Domochip/WirelessTouchLight/box/WirelessTouchLight Lid.stl

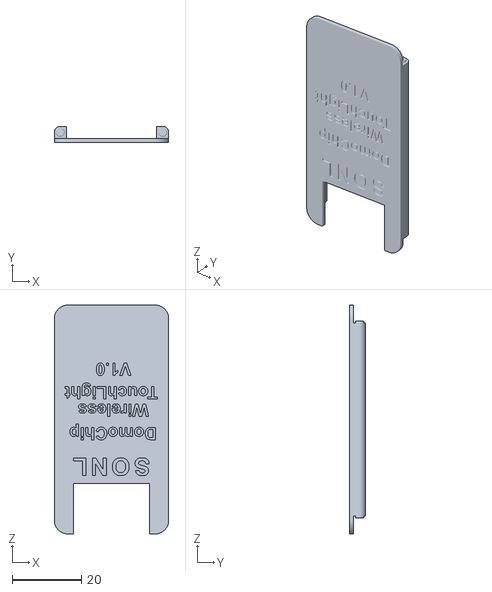
[picture p1: CAD file, 2019-11-03]
box/WirelessTouchLight Lid.stl
33.0 x 4.75 x 66.0
