Domochip/WirelessTouchLight/box/WirelessTouchLight Box.stl

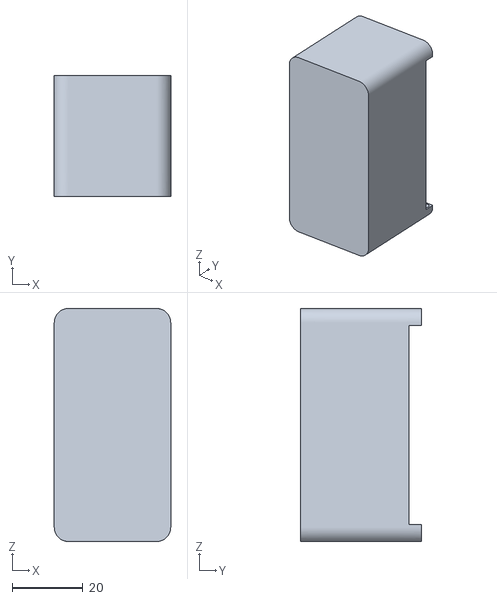
[picture p2: CAD file, 2019-11-03]
box/WirelessTouchLight Box.stl
33.0 x 34.2 x 66.0
