Domochip/WirelessTouchLight/(list of files, cad)

Other CAD files:
box/WirelessTouchLight v5.f3d
