Domochip/WirelessTouchLight/schematic/WirelessTouchLight.kicad_pcb

## KiCad design schematic/WirelessTouchLight.kicad_pcb (2020-03-07)

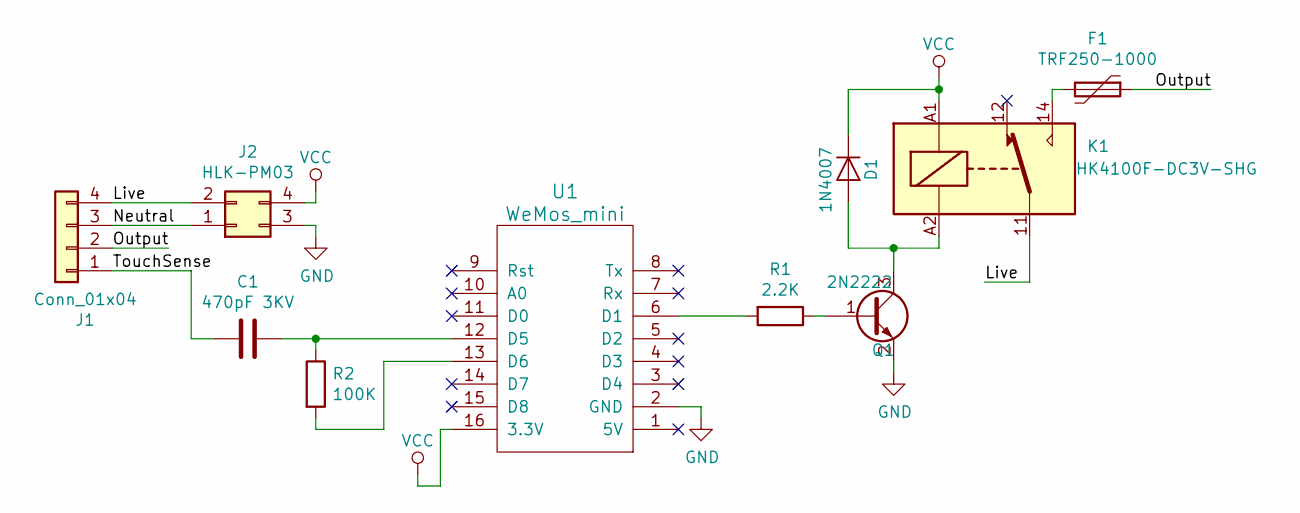
[picture p3: schematic WirelessTouchLight.sch]

Parts:
C1: 470pF 3KV; CP_Radial_Tantal_D4.5mm_P5.00mm
D1: 1N4007; D_SMA_Handsoldering
F1: TRF250-1000
J1: Conn_01x04; KF235-4P
J2: HLK-PM03; HLK-PM01
K1: HK4100F-DC3V-SHG; HK4100F
Q1: 2N2222; SOT-23_Handsoldering
R1: 2.2K; R_0805_HandSoldering
R2: 100K; R_0805_HandSoldering
U1: WeMos_mini; wemos-d1-mini-DIL-only

Connections:
/Live: J1.4, J2.2, K1.11
/Neutral: J1.3, J2.1
/Output: F1.1, J1.2
/TouchSense: C1.2, J1.1
GND: J2.3, Q1.2 (E), U1.2 (GND)
unnamed: C1.1, R2.1, U1.12 (D5)
unnamed: D1.2 (A), K1.A2, Q1.3 (C)
unnamed: F1.2, K1.14
unnamed: Q1.1 (B), R1.1
unnamed: R1.2, U1.6 (D1)
unnamed: R2.2, U1.13 (D6)
VCC: D1.1 (K), J2.4, K1.A1, U1.16 (3.3V)

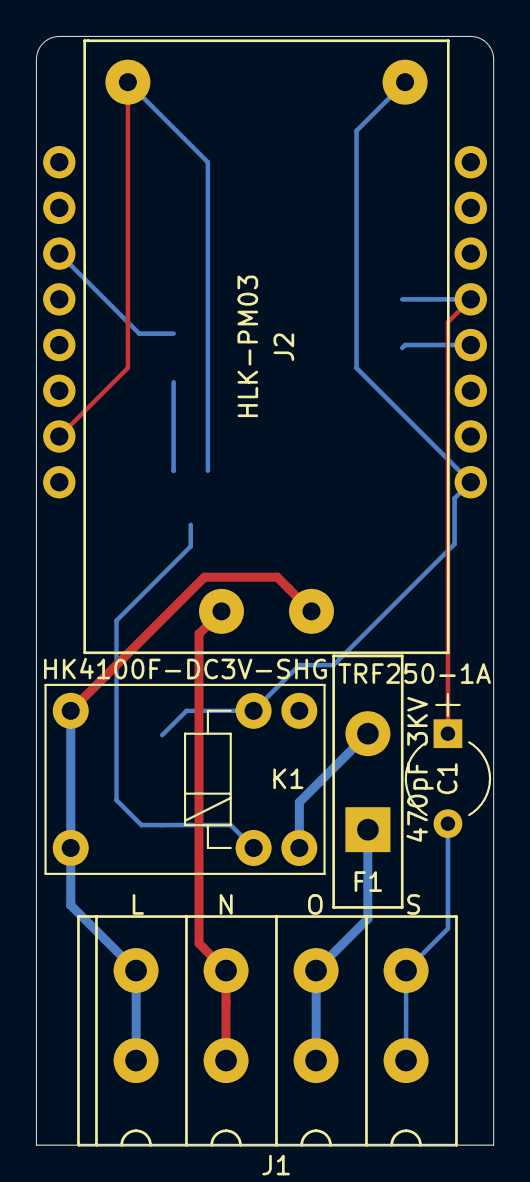
[picture p4: board WirelessTouchLight.kicad_pcb from above]

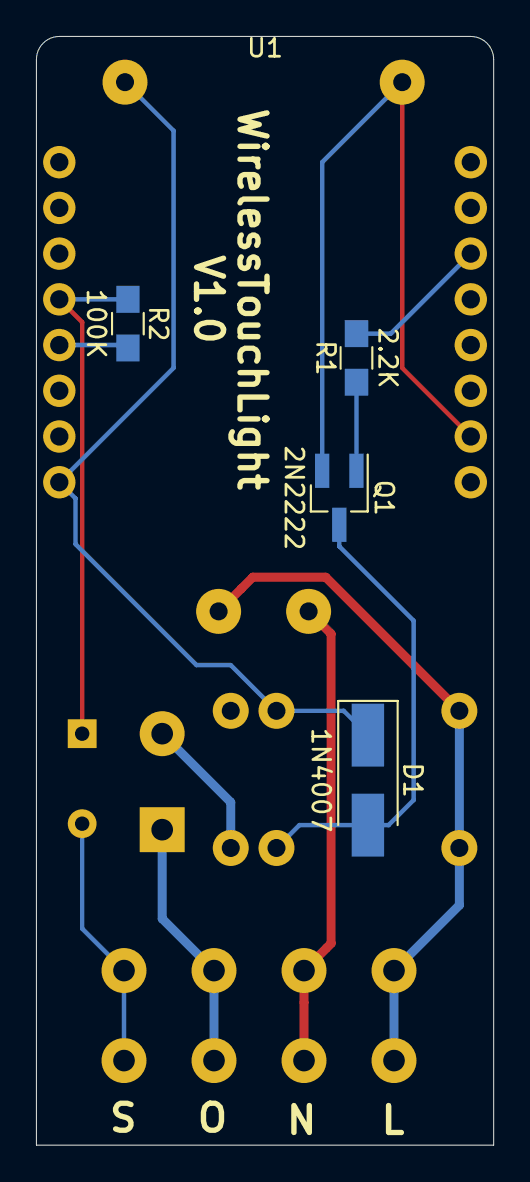
[picture p5: board WirelessTouchLight.kicad_pcb from below]

Board: 2 copper layers, 25.4 x 61.6 mm, 10 parts (5 on the bottom side), 12 nets.
