Domochip/WirelessTouchLight/(commit log)

2019-09-29 Add schematic
    [WirelessTouchLite.kicad_pcb, WirelessTouchLite.sch]
2019-10-02 change to D1 Mini Shelly 1 is noisy!
    [WirelessTouchLight.kicad_pcb, WirelessTouchLight.sch, WirelessTouchLite.sch]
2019-10-10 Update schematic
    [WirelessTouchLight-B_Cu.gbl, WirelessTouchLight-B_Mask.gbs, WirelessTouchLight-B_Paste.gbp, WirelessTouchLight-B_SilkS.gbo, WirelessTouchLight-Edge_Cuts.gm1, WirelessTouchLight-F_Cu.gtl, WirelessTouchLight-F_Mask.gts, WirelessTouchLight-F_Paste.gtp]
2019-11-03 V0.9 Switch to D1 Mini
2019-11-03 Add Box
    [WirelessTouchLight Box.stl, WirelessTouchLight Lid.stl, WirelessTouchLight v5.f3d]
2019-11-24 Change to 470K Resistor
    [WirelessTouchLight-B_Cu.gbl, WirelessTouchLight-B_Mask.gbs, WirelessTouchLight-B_Paste.gbp, WirelessTouchLight-B_SilkS.gbo, WirelessTouchLight-Edge_Cuts.gm1, WirelessTouchLight-F_Cu.gtl, WirelessTouchLight-F_Mask.gts, WirelessTouchLight-F_Paste.gtp]
2019-11-24 V1.1.1 add last Capactive sensor Value to status
2019-12-03 Remove CapacitiveSensor
2019-12-05 Change Back to 100K resistor (470 too much noises)
    [WirelessTouchLight.kicad_pcb, WirelessTouchLight.sch]
2019-12-05 V1.2.0 switch back to CapacitiveSensor
2019-12-05 Improve Web for calibration
2019-12-05 V1.2.3 use threshold level instead of sampleNumber
2020-03-07 Update schematic/PCB
    [WirelessTouchLight.kicad_pcb, WirelessTouchLight.sch]
